dmBots/dm-mc01/README.md

# DM-MC01

[中文](./README.zh.md) | EN

## Overview

This repository contains public materials for the DM-MC01 control board. Only directories with real content are kept, and empty placeholder directories are removed.

## Contents

- [说明书/](说明书/) - Manuals, datasheets, and interface documents
- [2D图纸/](2D图纸/) - 2D drawings, pinout diagrams, schematics, and footprint references
- [3D模型/](3D模型/) - STEP, STP, SolidWorks, and packaged 3D model files
- [例程/](例程/) - Example projects and reference code for the control board

## Maintenance Rules

- Add new materials to the matching Chinese directory and do not add empty placeholder folders.
- Keep 2D drawings and 3D models directly under 2D图纸/ and 3D模型/.
- Keep code projects, third-party projects, and existing archives under their original file names to avoid breaking customer paths.
