dmBots/dm-mc01/models/3d/imu-bmi088-module/DM_imu-V1.0.step

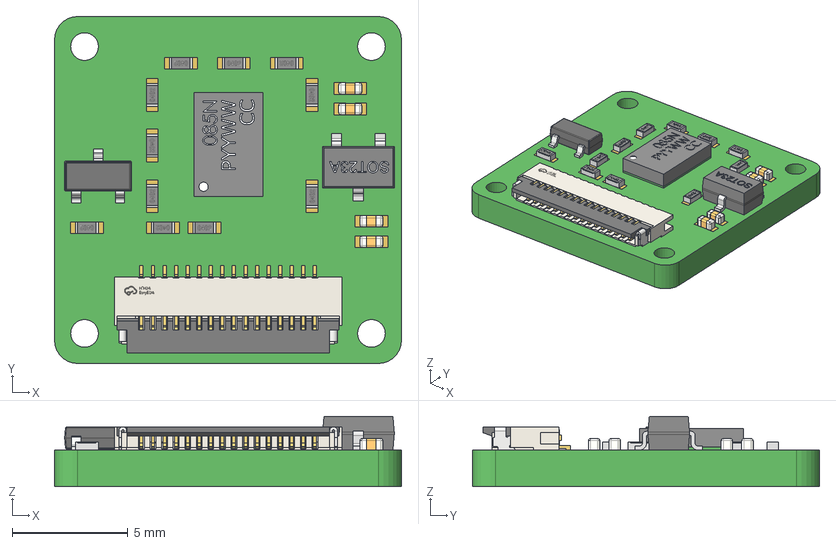
[picture p22: CAD file, 2024-08-02]
models/3d/imu-bmi088-module/DM_imu-V1.0.step
15.0 x 15.0 x 3.03 mm
R0402 x 11
Extruded x 30
User Library-SOT23A
User Library-16-LGA
sot-23-3-infineon
COMPOUND.step
