dmBots/dm-mc01/models/3d/lcd-module/DM_TFT-V1.1.step

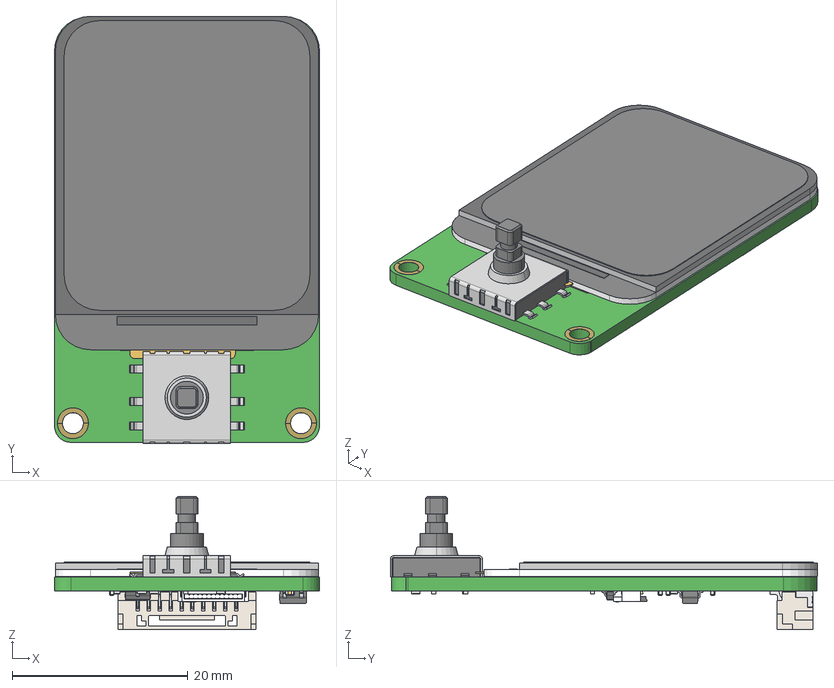
[picture p23: CAD file, 2026-06-29]
models/3d/lcd-module/DM_TFT-V1.1.step
30.2 x 48.7 x 15.2 mm
K1-1504SA-06 x 24
Extruded x 38
User Library-SOT23A
COMPOUND.step
R0402 x 12
sot-23-3-infineon
1.69¡± Round IPS x 57
SOLID.step
