dmBots/dm-mc01/(list of files, cad)

Other CAD files:
V2/models/主控/mc01-v2_0.stp
