dmBots/dm-mc01/说明书/USAGE.md

# DM-MC01 使用说明

## 概述
- 本文档收纳从 README 迁移出来的使用提示和查阅顺序。
- 如果你只想找资料入口，回到 [../README.md](../README.md)。

## 使用流程
1. 先查看本目录内的说明书 PDF。
2. 需要接线或板卡识别时，查看 [图纸/2d/schematics/](../图纸/2d/schematics/) 和 [MC_Board管脚配置图.png](../图纸/2d/MC_Board管脚配置图.png)。
3. 需要模块资料时，按需打开 [图纸/2d/lcd-module/](../图纸/2d/lcd-module/) 和 [图纸/2d/imu-bmi088-module/](../图纸/2d/imu-bmi088-module/)。
4. 需要上手验证时，先看 [示例/](../示例/)；数据参数和封装细节可参考 [datasheets/](datasheets/) 与 [模型/3d/customer-enclosure/](../模型/3d/customer-enclosure/)。

## 备注
- 本目录没有独立的安装脚本或环境初始化流程。
- 未确认内容保持 `TBD` 或 `Translation pending`。
