dmBots/dm-mc01/V2/examples/C593_all/mc01_rc_all_cmake/docs/imu_heater_test_report_2026-09-08.md

# MC01-RC IMU 加热温控实板测试报告

## 1. 测试结论

测试日期：2026-09-08

基于 BMI088 内部温度数据和 TIM2_CH3/PB10 的 1 kHz PWM，IMU 加热闭环温控功能通过实板测试。温度从 30.50°C 上升并稳定在 45°C 附近，记录到的最高温度为 46.25°C，最大过冲为 1.25°C。温控长期运行测试的最终观测温度为 45.000°C，占空比为 15.6%，已连续约 107 秒保持在目标温度 ±0.5°C 范围内，控制器和传感器故障码均为 0。

六轴采集门控也通过实板测试：升温阶段仅以 1 kHz 读取温度；温度连续 10 秒处于 45°C ±0.5°C 后，自动启用加速度计和陀螺仪 1 kHz 采集。门控前六轴样本数保持为 0，门控后读取错误和漏采均为 0。

## 2. 测试环境

- 目标器件：STM32C5A3RGT6
- 温度反馈：BMI088 内部温度数据
- PWM 输出：TIM2_CH3 / PB10
- PWM 配置：1 kHz、PWM1、高有效、初始占空比 0%
- 加热电源使能：PC15，高有效
- 板卡供电：24 V 已接入
- 调试器：DAPLink，UID `D641959C00B43ECC`
- 下载与调试工具：项目 `.venv` 中的 pyOCD
- 构建预设：`debug_GCC_STM32C5A3RGT6`

pyOCD 下载时提示目标包缺少 Flash programming debug sequence，随后自动回退到 FLM；擦除和编程均成功，不影响测试结论。

## 3. 温控参数

| 参数 | 配置 |
| --- | ---: |
| 目标温度 | 45.000°C |
| 过温关闭阈值 | 60.000°C |
| 控制周期 | 20 ms / 50 Hz |
| 稳态判定范围 | 目标温度 ±0.500°C |
| 稳态判定时间 | 连续 10 s |
| 最大占空比 | 50.0% |
| 比例系数 | 20‰/(°C) |
| 积分系数 | 1‰/(°C·s) |
| 温度数据超时 | 500 ms |

参数集中定义在 `board/board_config.h`，用户可以直接修改目标温度、PI 参数、限幅和保护阈值。

## 4. 软件结构

- `board/bsp/bsp_heater.c`：仅封装 TIM2_CH3 启动、千分比占空比设置和安全关闭。
- `app/imu_heater.c`：实现整数 PI、积分抗饱和、温度稳定判定、传感器超时和过温保护。
- `app/imu_test.c`：升温阶段以 1 kHz 读取 BMI088 温度，稳定满 10 秒后再启用加速度计和陀螺仪 1 kHz 采集。
- `main.c`：在现有协作式主循环中依次轮询 IMU 采样和温控应用，不使用阻塞延时。

温控初始化时先关闭加热 5 V，确保 PWM 以 0% 启动后再打开电源。传感器失效、PWM 设置失败或温度达到 60°C 时，会将 PWM 置零、停止 TIM2 通道并关闭加热 5 V 使能。

## 5. 测试方法

1. 使用 CMake Debug 预设编译固件。
2. 使用 DAPLink + pyOCD 下载 ELF 并复位运行。
3. 分阶段暂停 MCU，读取 `imu_heater_status`、`imu_test_status`、TIM2 寄存器和 GPIOC 输出寄存器。
4. 核对升温过程中的温度、误差、占空比、稳态时间、峰值温度和故障状态。
5. 在达到目标后继续运行约 3.5 分钟，检查积分回退和长期稳态。
6. 重新下载采集门控固件，分别在升温阶段、接近目标温度以及稳定满 10 秒后读取温度与六轴计数器。

## 6. 升温与收敛结果

| 控制运行时间 | 温度 | 误差 | 占空比 | 状态 | 已记录峰值 |
| ---: | ---: | ---: | ---: | --- | ---: |
| 约 4.9 s | 33.250°C | +11.750°C | 30.1% | 升温 | 33.250°C |
| 约 37.9 s | 44.750°C | +0.250°C | 23.0% | 调节 | 44.750°C |
| 约 56.0 s | 45.750°C | -0.750°C | 20.2% | 继续调节 | 45.875°C |
| 约 102.3 s | 45.500°C | -0.500°C | 16.2% | 调节 | 46.250°C |
| 约 146.2 s | 45.125°C | -0.125°C | 15.5% | 稳态 | 46.250°C |
| 约 209.0 s | 45.000°C | 0.000°C | 15.6% | 稳态 | 46.250°C |

初始温度和测试期间最低温度均为 30.50°C。最终状态如下：

- `result = 2`：通过
- `state = 3`：稳态
- `fault = 0`：无故障
- 连续稳态时间：约 107.26 s
- 最大过冲：1.25°C

## 7. 稳温后采集门控验证

| 观测点 | 温度 | 温度轮询数 | 六轴样本数 | 六轴采集使能 | 结论 |
| --- | ---: | ---: | ---: | ---: | --- |
| 复位后约 5 s | 39.500°C | 4862 | 0 | 0 | 仅采温度用于温控 |
| 运行约 52.4 s | 44.250°C | 52414 | 0 | 0 | 尚未满足稳态条件，不采集六轴 |
| 连续稳态 30.74 s | 45.250°C | 83370 | 20750 | 1 | 稳定满 10 秒后已自动开始采集 |
| 连续稳态 55.54 s | 45.125°C | 108160 | 45540 | 1 | 六轴继续以 1 kHz 采集 |

最终观测中，连续稳态时间 55540 ms 与六轴样本数 45540 的差值正好为 10000 ms，符合“稳定满 10 秒后开始采集”的配置。门控打开后，温度轮询数和六轴样本数同步按 1 kHz 增长；SPI/API 读取错误为 0，轮询漏采为 0，轮询间隔最小值和最大值均为 1 ms。

## 8. PWM 与 IMU 运行观测

最终 TIM2 寄存器读回：

- `PSC = 143`
- `ARR = 999`
- `CCR3 = 156`
- `CCER.CC3E = 1`
- `CR1.CEN = 1`

以上对应 1 kHz PWM 和 15.6% 占空比。GPIOC 输出寄存器中 PC15 为高电平，加热 5 V 电源保持使能。

采集门控测试的最终 BMI088 状态：

- IMU 测试结果：通过
- 累计温度样本数：108160
- 门控后六轴样本数：45540
- SPI/API 读取错误：0
- 1 kHz 轮询漏采：0
- 轮询间隔最小值/最大值：1 ms / 1 ms

## 9. 结论边界

本次实测证明 1 kHz PWM 输出、BMI088 温度反馈、PI 调节、占空比限幅、稳态控制和稳温后六轴采集门控有效。由于缺少加热小板原理图，当前 50% 最大占空比作为保守限制保留；若更换加热小板、电阻阻值、MOSFET 或机械安装方式，需要重新验证升温速度并调整 PI 参数。

过温和传感器超时关闭路径已进行源码与构建检查。本次没有人为将板卡加热到 60°C 来触发过温保护，以避免不必要的硬件热应力。
