dmBots/dm-mc01/V2/examples/C593_all/mc01_rc_all_cmake/docs/lcd_st7789_test_report_2026-09-08.md

# CtrBoard-V2 ST7789 与五向按键 ADC2 测试报告

- 测试日期：2026-09-08
- 目标 MCU：STM32C5A3RGT6
- 调试下载：DAPLink + pyOCD
- 参考工程：`C:\Users\93094\Desktop\dm-mc02-master\例程\CtrBoard-H7_LCD`
- 测试固件：`build/debug_GCC_STM32C5A3RGT6/mc01_rc_all.elf`

## 1. 结论

旧工程默认 LCD 界面、ST7789 SPI1 TX DMA 驱动和 `ADC2_CH4_KEY` 五向按键原始值采集已完成移植。固件编译、DAPLink 下载和板端运行均通过。

- LCD 初始界面自检：`PASSED`
- ADC2 连续 DMA 采集测试：`PASSED`
- LCD/ADC2 DMA 错误：0
- ADC2 采样超时：0
- 既有 CAN、RS485、USART、VBAT、BMI088、IMU 加热和 TIM8 测试：均为 `PASSED`

LCD 为只写接口，板端无法回读显存，因此文字和图片最终外观仍需人工观察确认；MCU 侧命令、数据长度、DMA 完成和刷新计数均已验证。

## 2. 旧例程默认界面核对

旧工程 `Core/Src/main.c` 的默认流程不是单独显示一张图片，而是：

1. 初始化 LCD 并清为黑色。
2. 在 `(120,72)` 显示棕红色 `dmBot`，12×24 ASCII 字体。
3. 在 `(84,100)` 显示白色 `达妙科技`，32×32 汉字字模。
4. 在 X=10 和 X=270 位置绘制两条白色竖线。
5. 在 `(50,170)` 以 16×32 ASCII 字体显示 5 位 ADC 按键原始值。
6. 在 `(180,150)` 显示右下角图片。

当前例程已按上述布局恢复。旧代码把高度 240 的屏幕竖线画到 Y=280，本次将终点限制为 Y=239，避免越界。

## 3. LCD 硬件配置

| 屏幕信号 | 原理图网络/MCU 引脚 | 配置 | 作用 |
| --- | --- | --- | --- |
| CS | SPI1_CS / PA4 | GPIO 推挽输出，初始高 | 软件片选，低有效 |
| SCK | SPI1_SCK / PA5 | SPI1 AF5 | 串行时钟 |
| SDA | SPI1_MOSI / PA7 | SPI1 AF5 | 单向显示数据 |
| BLK | IIC2_SCL / PB3 | GPIO 推挽输出 | 背光，高有效 |
| RES | IIC2_SDA / PB4 | GPIO 推挽输出、上拉 | 硬件复位，低有效 |
| DC | PC01 / PC1 | GPIO 推挽输出 | 命令/数据选择 |

`IIC2_SCL` 和 `IIC2_SDA` 在 LCD 用途中只是原理图网络名，分别作为 BLK 和 RES 普通 GPIO 输出，不启用 I2C 功能。

SPI1 配置为主机、8 bit、MSB first、CPOL Low、CPHA 1 Edge（Mode 0）、内部 NSS、预分频 16。板端实测 SPI1 内核时钟 144 MHz，SCLK 为 9 MHz。SPI1 TX 使用 LPDMA2 Channel 3。

## 4. ADC2 五向按键配置

| 项目 | 配置 |
| --- | --- |
| 网络名 | ADC2_CH4_KEY |
| MCU 引脚 | PC4 / ADC2_IN4 |
| 分辨率 | 12 bit |
| 采样时间 | 289 cycles |
| 转换方式 | 软件触发、单次规则组转换 |
| DMA | LPDMA2 Channel 2，外设到内存，word 宽度 |
| 采样周期 | 20 ms |
| LCD 刷新周期 | 100 ms |
| 单次采样超时 | 10 ms |

旧例程只显示 ADC 原始值，没有给出上、下、左、右、中心五个档位的电压阈值。本次保持这一行为，不对阈值作未经实测的假设；BSP 和应用 API 已提供 12 位原始值及序号，后续可采集五个按键档位后增加方向解析。

## 5. 软件结构

- `board/board_config.h`：LCD 与按键 ADC 的周期、超时、尺寸及引脚配置。
- `board/bsp/bsp_lcd.c/.h`：轻量 LCD 总线接口，负责 GPIO、SPI1 DMA 和中断事件。
- `board/bsp/bsp_adc.c/.h`：ADC1 VBAT 与 ADC2 KEY 共用的轻量异步 DMA 采样实现。
- `app/key_test.c/.h`：按键连续采样、状态统计及最新原始值用户接口。
- `app/lcd.c/.h`：ST7789 非阻塞初始化、区域填充和 RGB565 图片发送。
- `app/lcd_font.c/.h`：只迁移默认界面使用的 ASCII 24、ASCII 32 和四个中文 32 字模。
- `app/lcd_picture.c/.h`：旧工程 RGB565 图片资源。
- `app/lcd_test.c/.h`：旧默认界面绘制、初始计数自检和按键值持续刷新状态机。

ADC 与 SPI 中断回调只设置完成/错误标志。停止 DMA、发布采样、界面步骤推进和刷新均在主循环轮询中处理。

## 6. 资源核对与修正

| 资源 | 大小 |
| --- | ---: |
| ASCII 12×24 字库 | 4560 字节 |
| ASCII 16×32 字库 | 6080 字节 |
| `达妙科技` 四个 32×32 字模 | 512 字节 |
| 旧 RGB565 图片 | 12160 字节 |

图片数组长度和元数据对应 80×76。旧工程调用 `LCD_ShowPicture(180,150,80,80,...)` 会越界读取 640 字节；本次按真实尺寸 80×76 显示，并保持 RGB565 高字节在前。

## 7. LCD 初始界面精确自检

初始界面包括清屏、`dmBot`、四个汉字、两条竖线、图片和第一次 ADC 数值，共 7 次绘制操作。

| 检查项 | 期望值 | 初始实测/判定 |
| --- | ---: | --- |
| 初始化命令数 | 15 | 15，通过 |
| DMA 完成次数 | 383 | 383，通过 |
| SPI 发送字节数 | 163847 | 163847，通过 |
| 绘制操作数 | 7 | 7，通过 |
| 发送像素数 | 81856 | 81856，通过 |
| 图片完成标志 | 1 | 1，通过 |
| LCD BSP 错误 | 0 | 0，通过 |
| LCD 驱动错误 | 0 | 0，通过 |

完成精确计数核对后，LCD 测试结果置为 `PASSED`，随后进入五向按键原始值持续刷新状态。

## 8. 持续运行实测快照

在固件持续运行约 42.8 秒后通过 SWD 读取：

### ADC2 KEY

| 字段 | 实测值 |
| --- | ---: |
| 测试结果 | PASSED (`2`) |
| 采样次数 | 2141 |
| 最新原始值 | 4007 |
| 最新引脚电压 | 3229 mV |
| DMA 完成次数 | 2141 |
| ADC 错误 | 0 |
| 超时次数 | 0 |

### LCD 持续刷新

| 字段 | 实测值 |
| --- | ---: |
| 测试结果 | PASSED (`2`) |
| 状态 | ACTIVE (`16`) |
| 失败掩码 | 0 |
| 屏幕上的按键原始值 | 4012 |
| 按键数值绘制次数 | 399 |
| 图片完成标志 | 1 |
| DMA 完成次数 | 6353 |
| SPI 发送字节数 | 2205985 |
| 绘制操作数 | 405 |
| 发送像素数 | 1100736 |
| LCD BSP/驱动错误 | 0 / 0 |

屏幕值与 ADC 最新值存在几毫秒级刷新时差属于正常现象。持续计数符合以下关系：

- DMA 次数 = `368 + 按键数值绘制次数 × 15`
- 发送字节 = `158716 + 按键数值绘制次数 × 5131`
- 绘制操作 = `6 + 按键数值绘制次数`
- 发送像素 = `79296 + 按键数值绘制次数 × 2560`

实测 399 次刷新全部满足上述关系，说明持续 DMA 分块和轮询调度没有丢失操作。

## 9. 既有功能回归

| 模块 | 最终固件状态 |
| --- | --- |
| CAN（当前 CANFD 8 Mbit/s 预设） | PASSED，mask `0x0F` |
| RS485 2 Mbaud 外部 Echo | PASSED，mask `0x3F` |
| USART1/USART3 单口回环 | PASSED，mask `0x3F` |
| VBAT ADC1 DMA | PASSED，100 个样本 |
| BMI088 | PASSED |
| IMU 加热控制 | PASSED，无故障 |
| TIM8 PWM 捕获回环 | PASSED |

## 10. 人工观察项

屏幕应为黑底，显示 `dmBot`、`达妙科技`、左右白线、右下角图片，以及位于 `(50,170)` 的五位 ADC 原始值。按动五向键时，该数值应随分压档位变化。若需要显示方向名称，应先记录松开、上、下、左、右、中心六种状态的稳定原始值，再配置判定区间。
