dmBots/dm-mc01/V2/drawings/管脚标注图.pdf

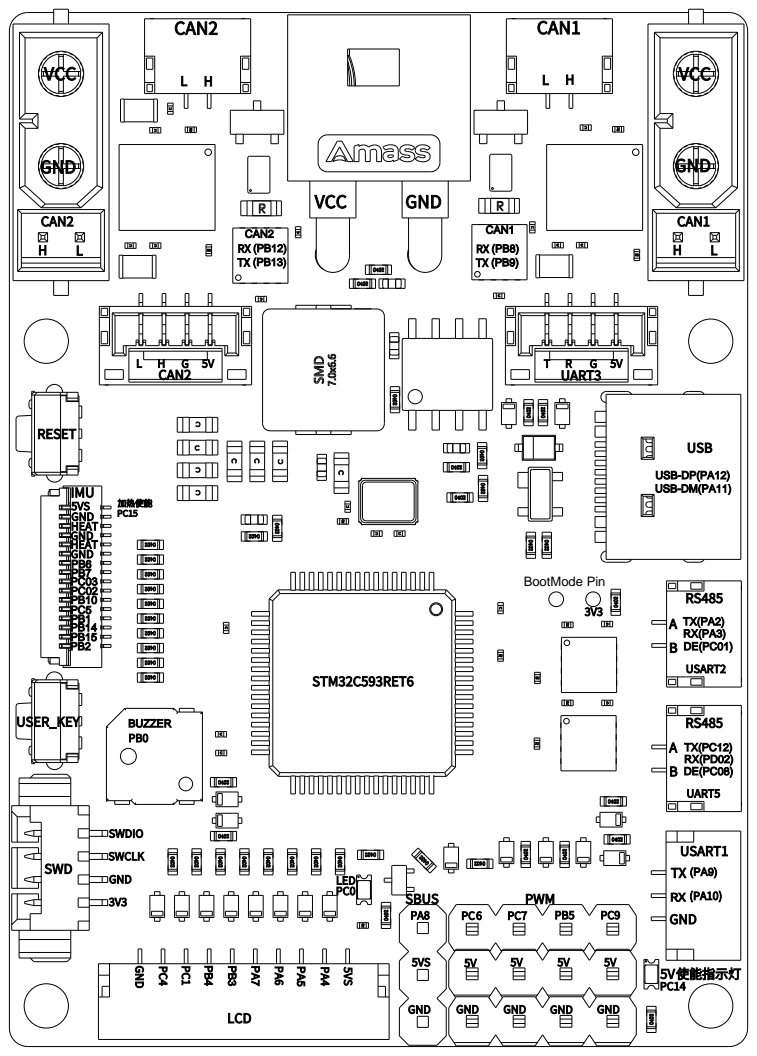
[picture p24: page 1]
BootMode Pin
