dmBots/dm-mc01/V2/drawings/DM_TFT-V1.1.pdf

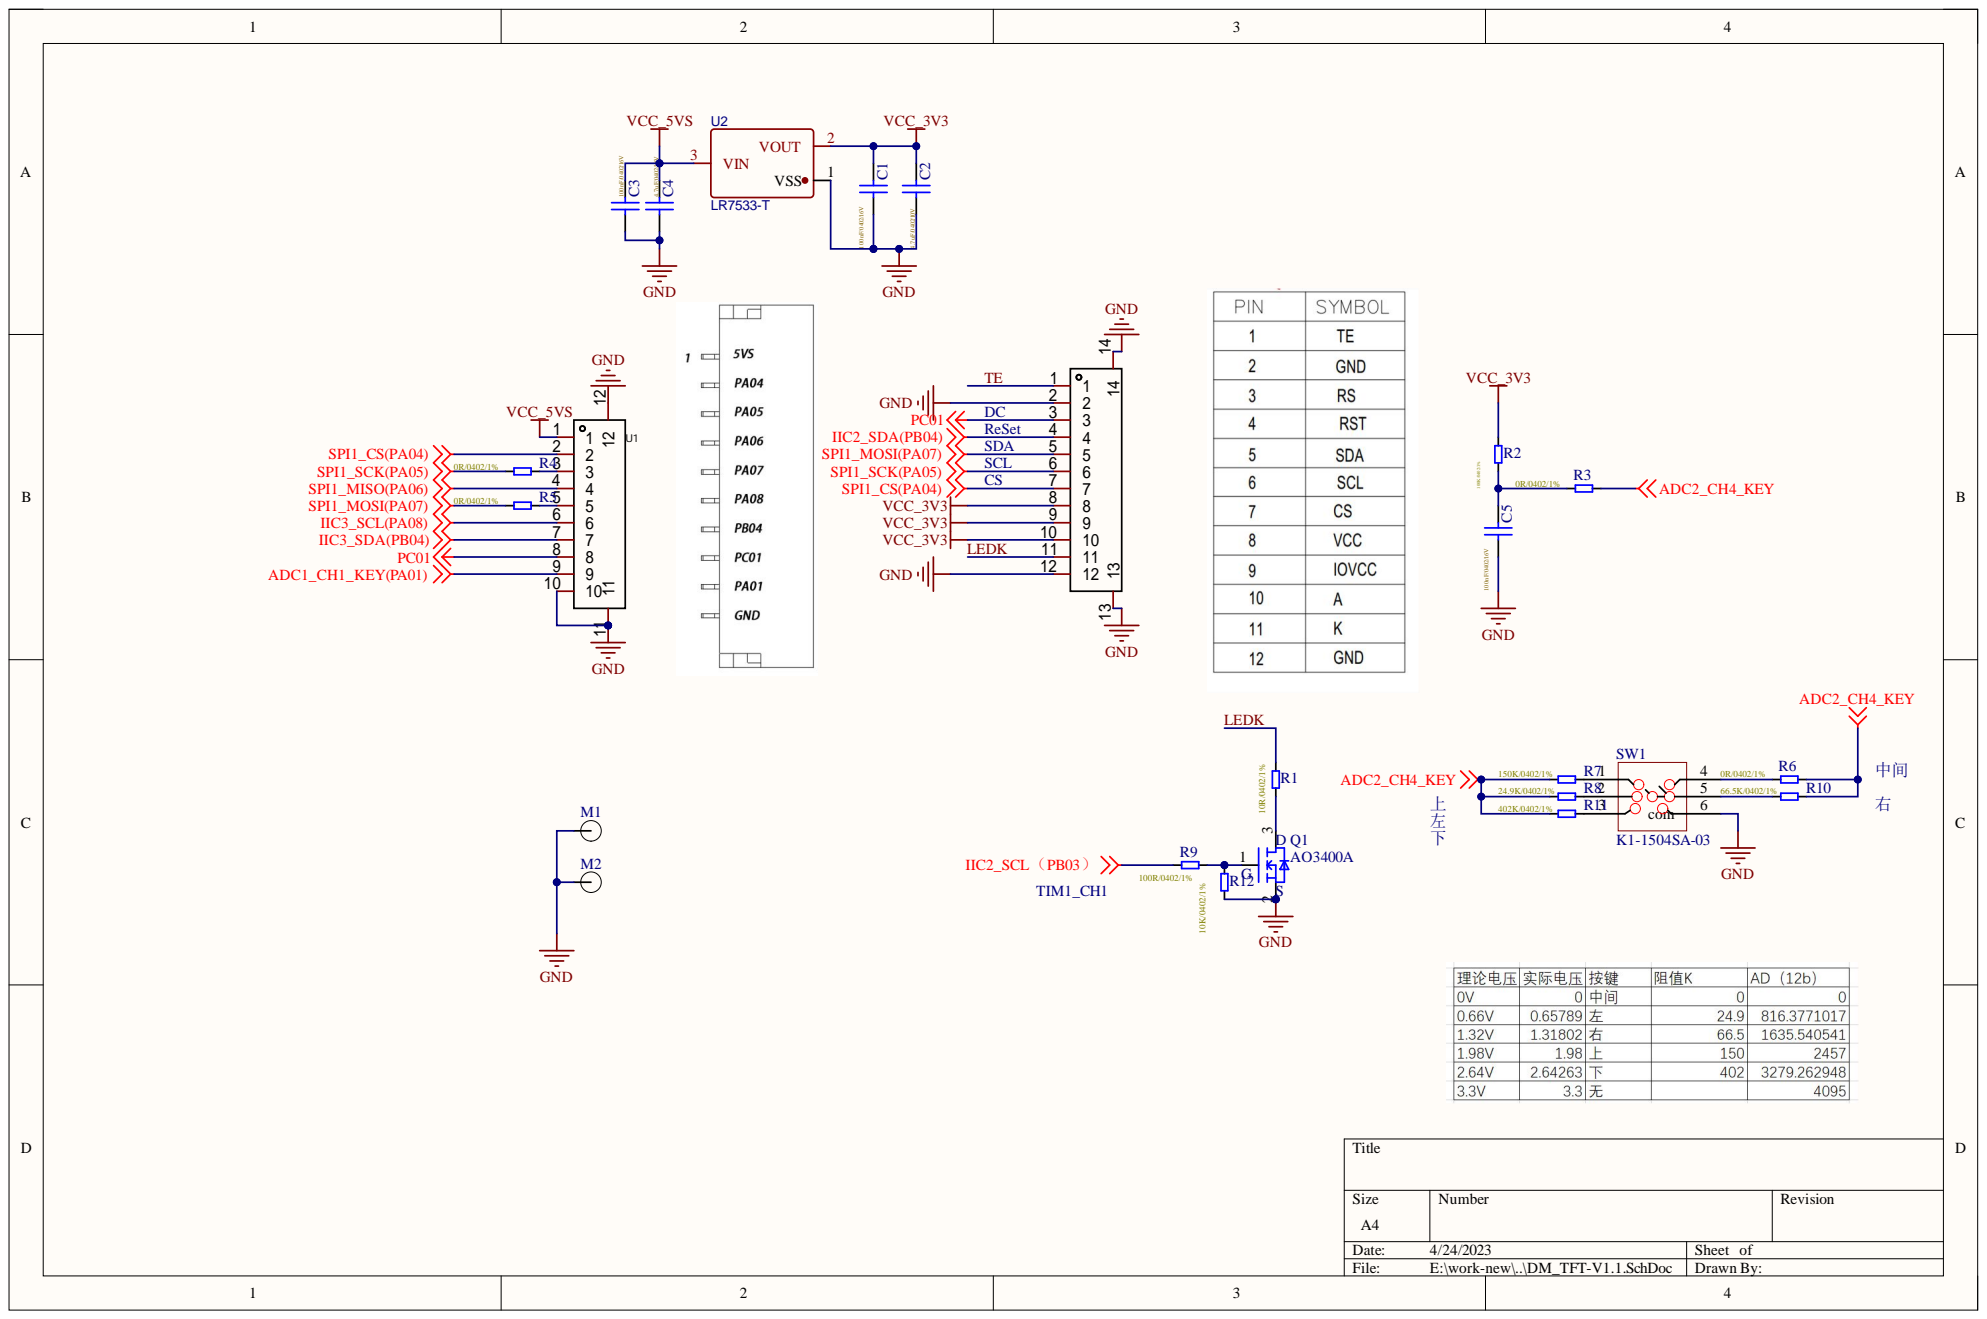
[picture p25: page 1]
