dmBots/dm-mc01/V2/drawings/mc01-v2_0.pdf

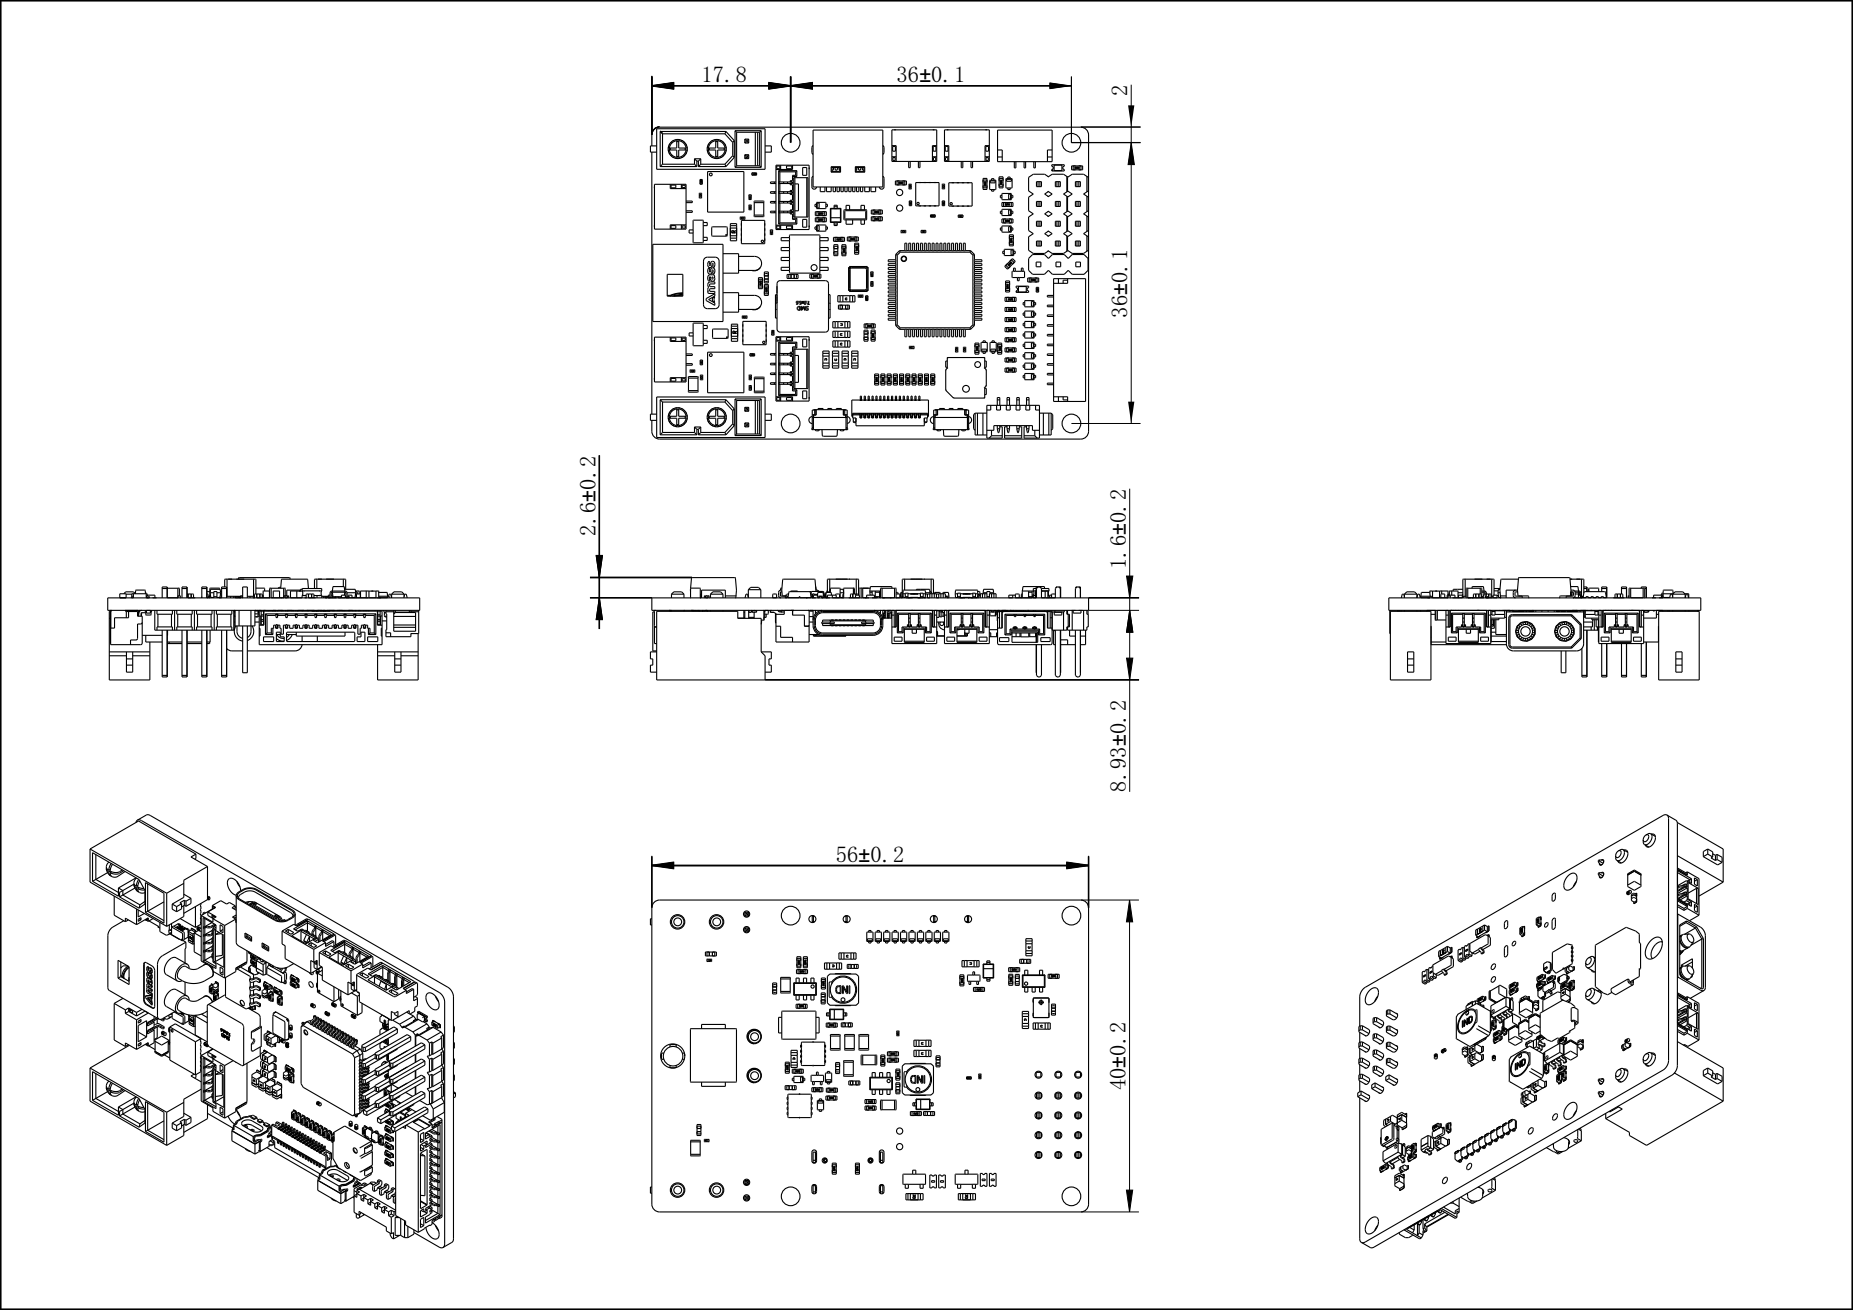
[picture p26: page 1]
