dmBots/dm-mc01/V2/drawings/MC_Board原理图.pdf

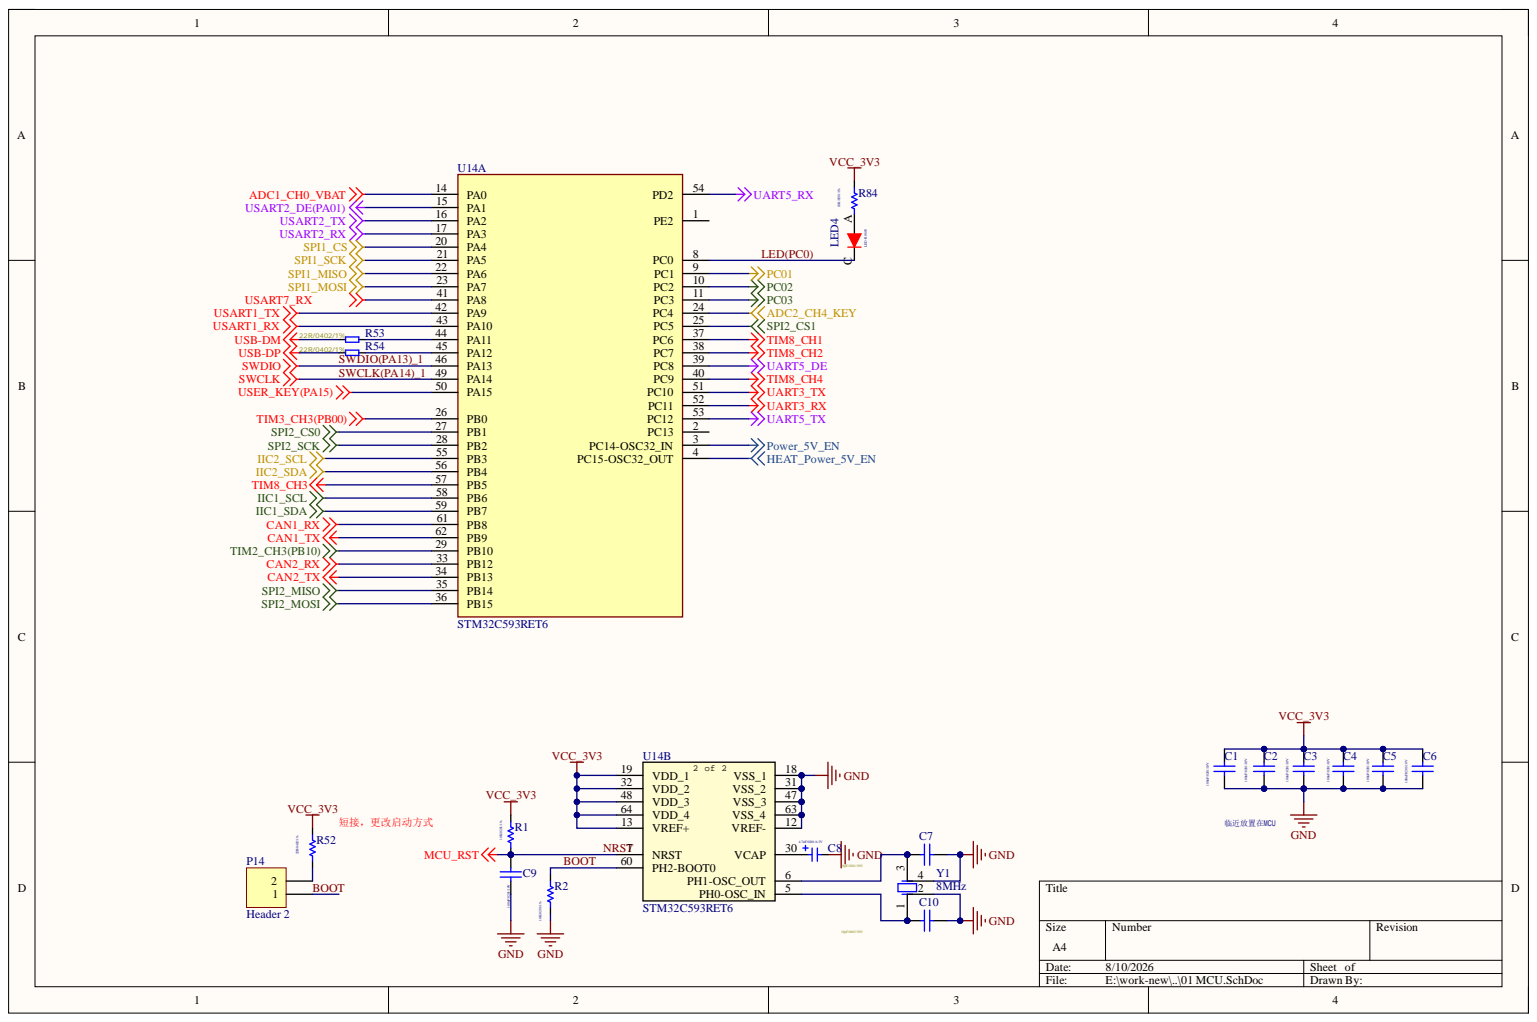
[picture p27: page 1]

4 | Y1
2 8MHz

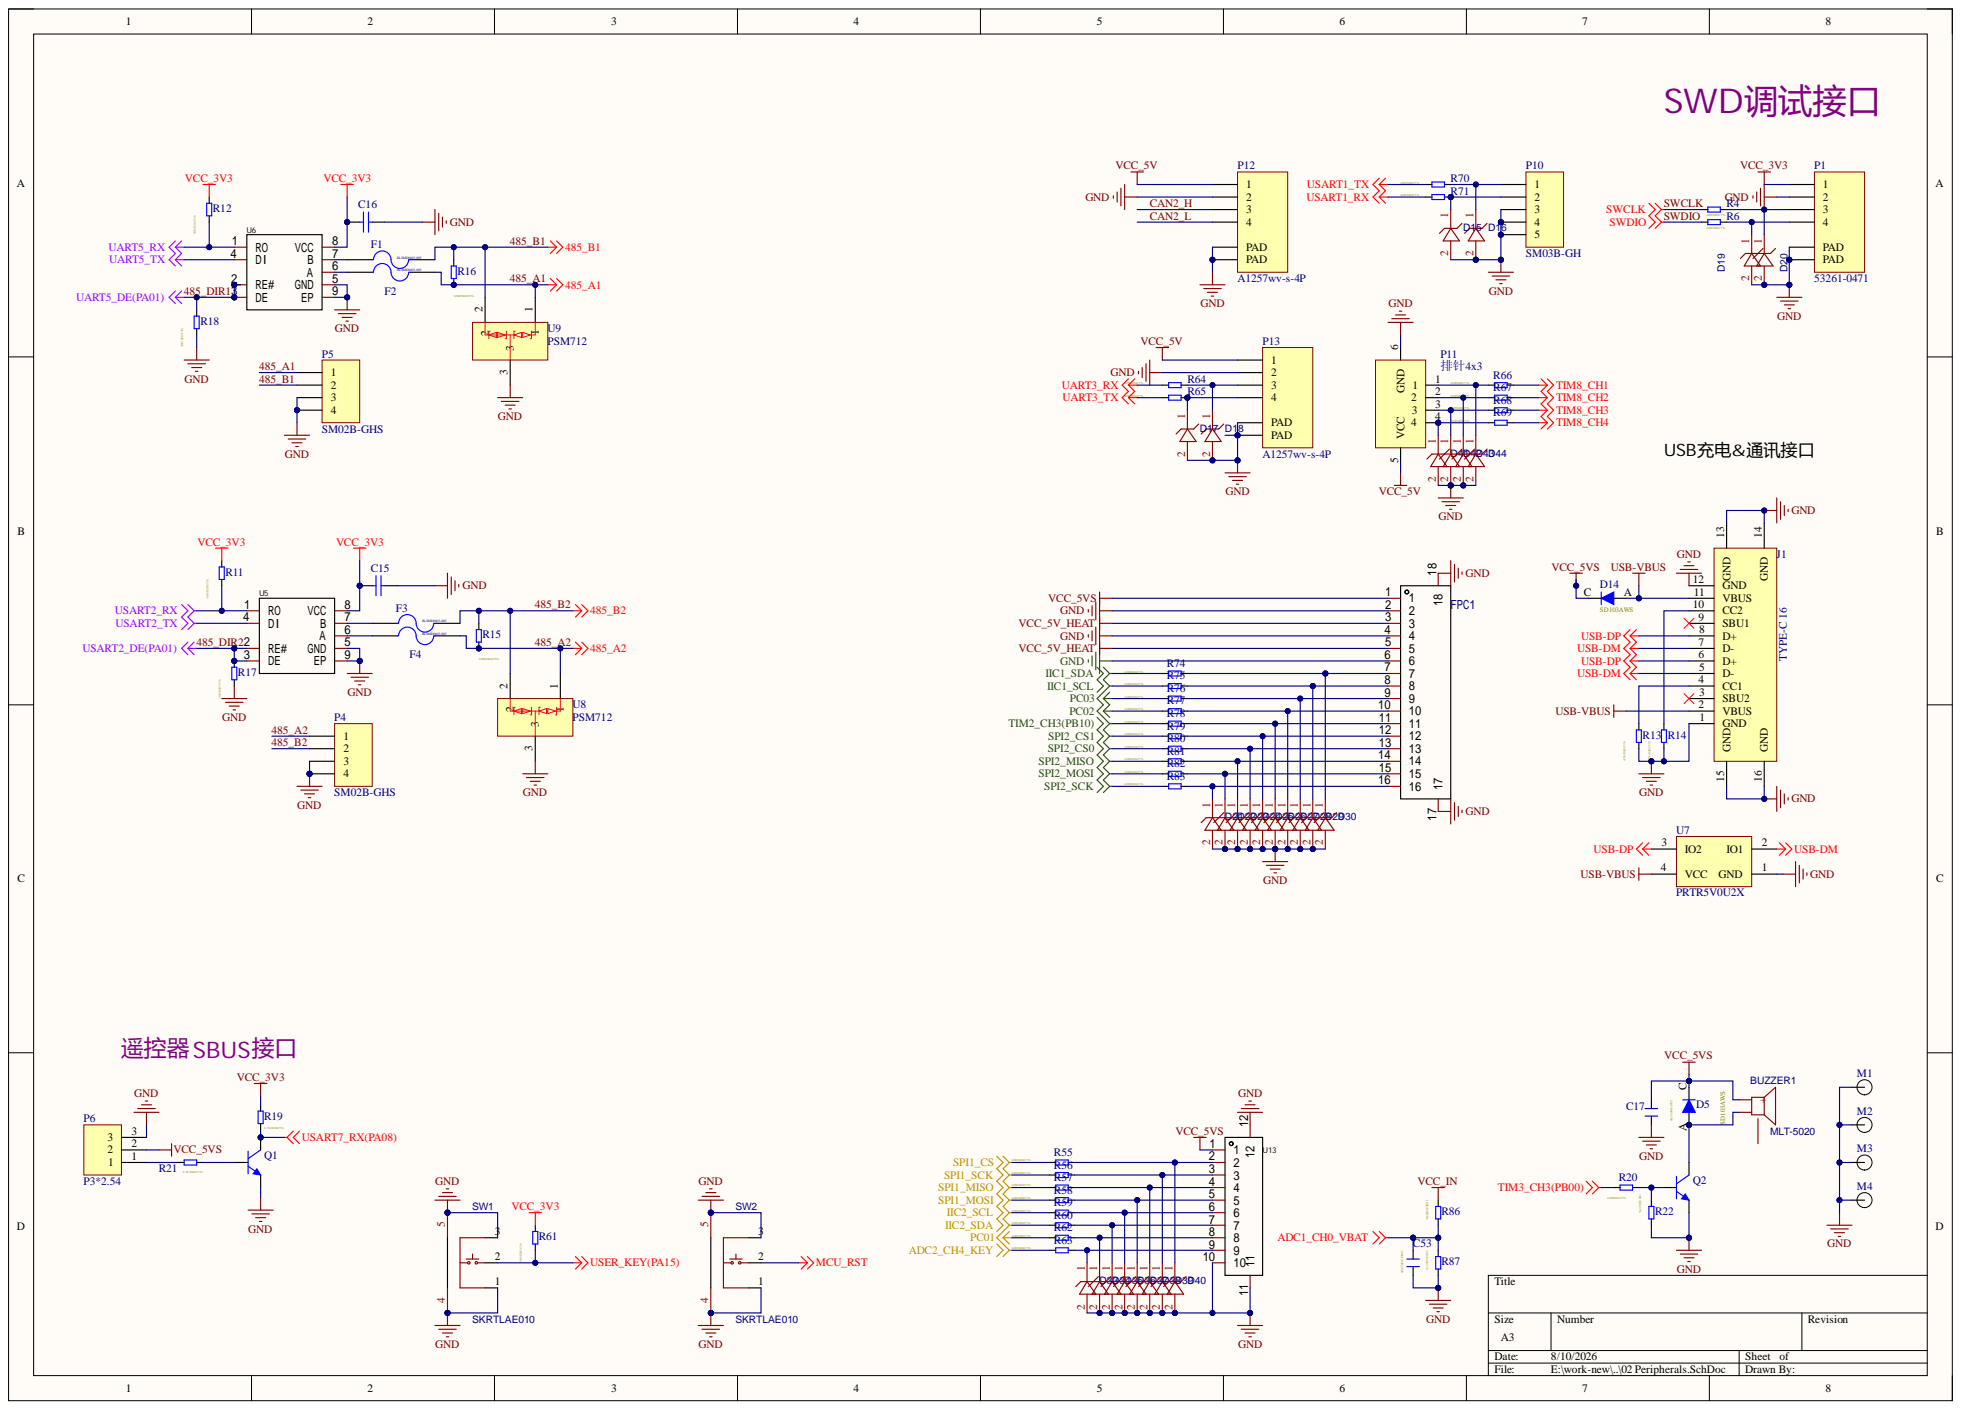
[picture p28: page 2]

10 10
11 11

13 13
14 14
15 15
16 16

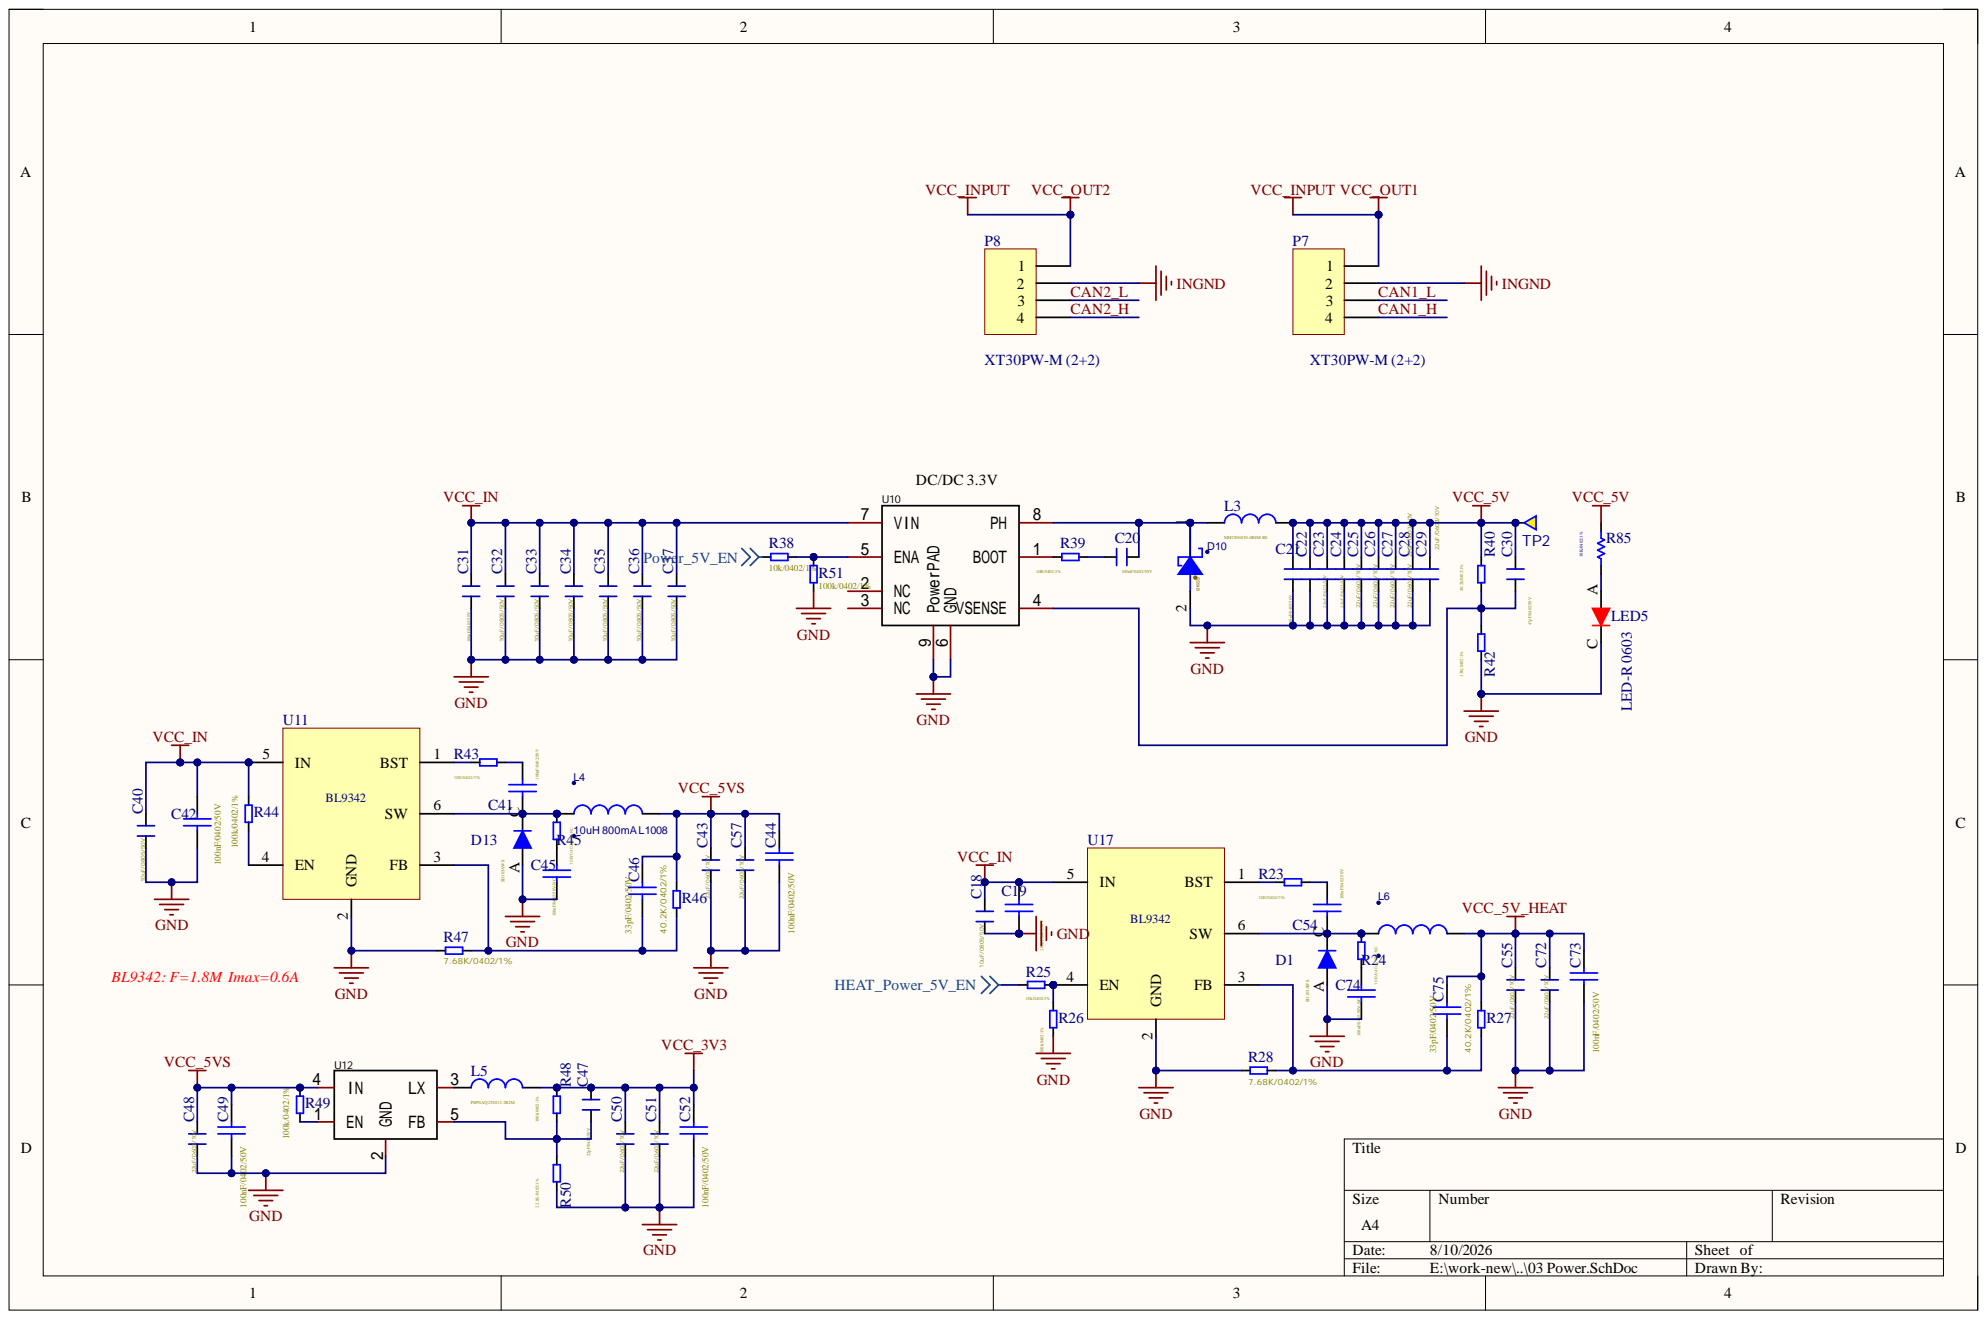
[picture p29: page 3]

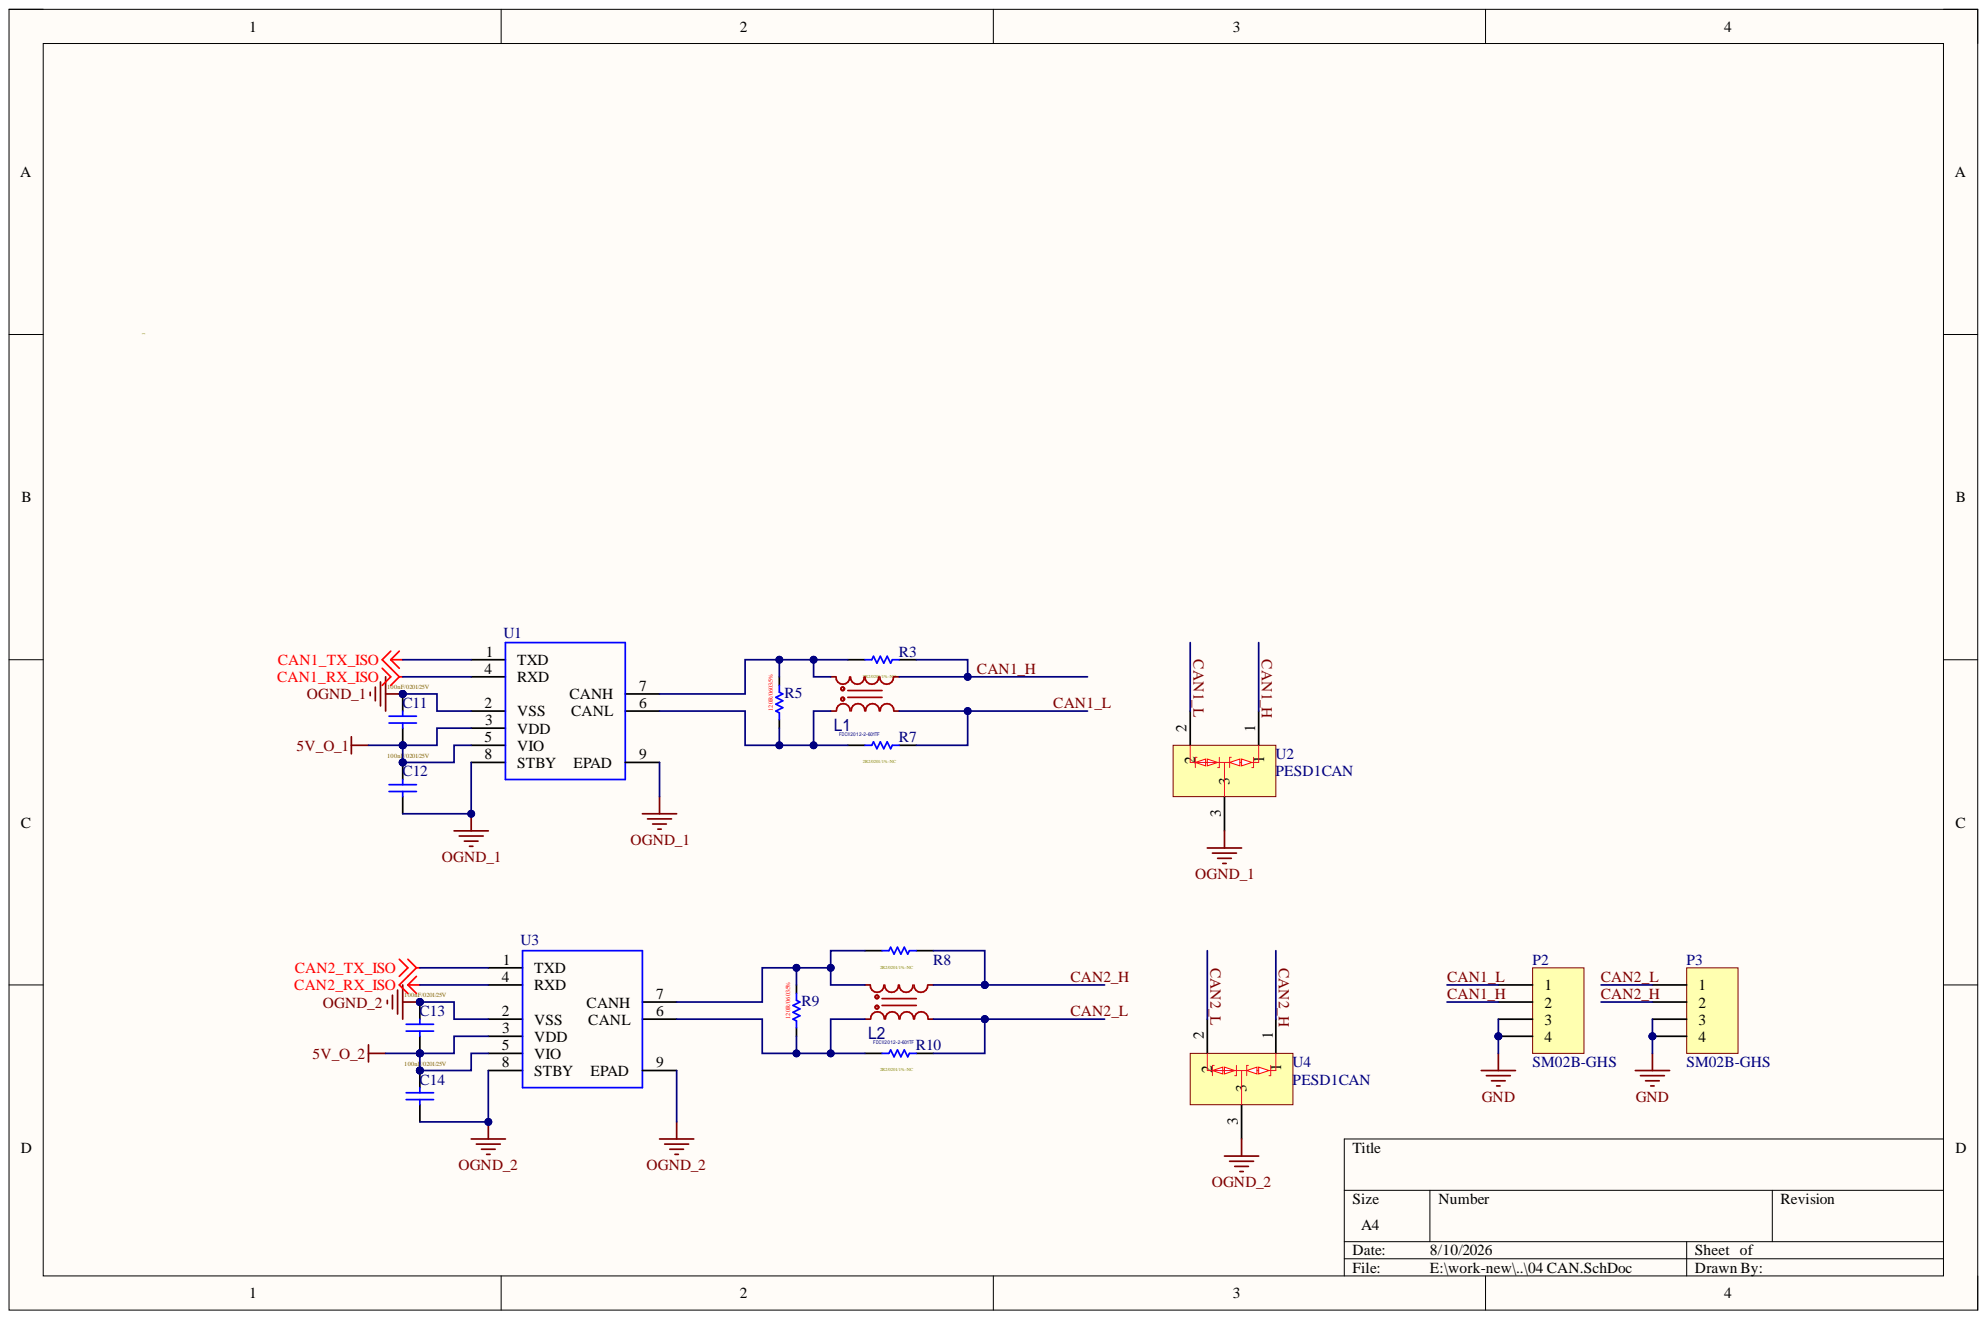
[picture p30: page 4]

VIO 5
STBY 8

VDD 3
