dmBots/dm-mc01/V2/examples/C593_all/mc01_rc_all_cmake/app/lcd_font.c

#include "lcd_font.h"

#include <stddef.h>

static const uint8_t lcd_ascii24[][48] = {
{0x00,0x00,0x00,0x00,0x00,0x00,0x00,0x00,0x00,0x00,0x00,0x00,0x00,0x00,0x00,0x00,0x00,0x00,0x00,0x00,0x00,0x00,0x00,0x00,0x00,0x00,0x00,0x00,0x00,0x00,0x00,0x00,0x00,0x00,0x00,0x00,0x00,0x00,0x00,0x00,0x00,0x00,0x00,0x00,0x00,0x00,0x00,0x00},/*" ",0*/
{0x00,0x00,0x00,0x00,0x00,0x00,0x00,0x00,0x60,0x00,0x60,0x00,0x60,0x00,0x60,0x00,0x60,0x00,0x60,0x00,0x60,0x00,0x40,0x00,0x20,0x00,0x20,0x00,0x20,0x00,0x00,0x00,0x00,0x00,0x00,0x00,0x60,0x00,0x60,0x00,0x60,0x00,0x00,0x00,0x00,0x00,0x00,0x00},/*"!",1*/
{0x00,0x00,0x00,0x00,0x60,0x06,0x60,0x06,0x30,0x03,0x98,0x01,0x88,0x00,0x44,0x00,0x00,0x00,0x00,0x00,0x00,0x00,0x00,0x00,0x00,0x00,0x00,0x00,0x00,0x00,0x00,0x00,0x00,0x00,0x00,0x00,0x00,0x00,0x00,0x00,0x00,0x00,0x00,0x00,0x00,0x00,0x00,0x00},/*""",2*/
{0x00,0x00,0x00,0x00,0x00,0x00,0x00,0x00,0x10,0x02,0x10,0x02,0x10,0x02,0x10,0x02,0xFE,0x07,0xFE,0x07,0x08,0x02,0x08,0x01,0x08,0x01,0x08,0x01,0x08,0x01,0xFE,0x07,0xFE,0x07,0x04,0x01,0x04,0x01,0x04,0x01,0x04,0x01,0x00,0x00,0x00,0x00,0x00,0x00},/*"#",3*/
{0x00,0x00,0x00,0x00,0x00,0x00,0x40,0x00,0x40,0x00,0xF0,0x01,0x58,0x03,0x4C,0x03,0xCC,0x03,0x4C,0x00,0x58,0x00,0x70,0x00,0xE0,0x00,0xC0,0x01,0xC0,0x01,0x40,0x03,0x4C,0x03,0x5C,0x03,0x4C,0x03,0x48,0x01,0xF0,0x00,0x40,0x00,0x40,0x00,0x00,0x00},/*"$",4*/
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
        0x80,0x01,0x86,0x01,0x80,0x01,0x84,0x01,0x80,0x01,0xCC,0x00,0x80,0x01,0x68,0x00,
        0x80,0x01,0x70,0x00,0x80,0x01,0x78,0x00,0x80,0x01,0xEC,0x00,0x80,0x01,0xC7,0x03,
        0xF8,0x81,0x01,0x1F,0xE0,0x71,0x00,0x3E,0x40,0x0C,0x00,0x00,0x00,0x00,0x00,0x00
    }
};

const uint8_t *lcd_font_get_ascii24(uint8_t character)
{
    if ((character < LCD_FONT_ASCII_FIRST) || (character > LCD_FONT_ASCII_LAST))
    {
        return NULL;
    }
    return lcd_ascii24[character - LCD_FONT_ASCII_FIRST];
}

const uint8_t *lcd_font_get_ascii32(uint8_t character)
{
    if ((character < LCD_FONT_ASCII_FIRST) || (character > LCD_FONT_ASCII_LAST))
    {
        return NULL;
    }
    return lcd_ascii32[character - LCD_FONT_ASCII_FIRST];
}

const uint8_t *lcd_font_get_chinese32(uint32_t index)
{
    if (index >= LCD_FONT_CHINESE32_COUNT)
    {
        return NULL;
    }
    return lcd_chinese32[index];
}
