dmBots/dm-mc01/V2/examples/C593_all/mc01_rc_all_cmake/app/lcd_picture.c

#include "lcd_picture.h"

const uint8_t lcd_picture_data[LCD_PICTURE_DATA_SIZE] = {
 /* 0X10,0X10,0X00,0X50,0X00,0X4C,0X01,0X1B, */
0XC5,0XB3,0XC5,0XB3,0XC5,0XB3,0XC5,0XB3,0XC5,0XB4,0XC5,0XB4,0XC5,0XB3,0XC5,0XB3,
0XC5,0XB3,0XC5,0XB3,0XC5,0XB3,0XC5,0X92,0XBD,0X92,0XBD,0X92,0XBD,0X92,0XBD,0X92,
0XBD,0X92,0XBD,0X92,0XBD,0X72,0X83,0XAC,0X73,0X2B,0X73,0X2B,0X62,0XEA,0X62,0XA9,
0X5A,0XA9,0X5A,0X89,0X5A,0XA8,0X5A,0XA8,0X41,0XE5,0X5A,0XA8,0X63,0X09,0X7B,0XCC,
0X8C,0X0E,0X8C,0X4E,0X94,0X6F,0X8C,0X4E,0X8C,0X0E,0X8C,0X2E,0X94,0X4F,0X94,0X6F,
0X9C,0XD0,0XA5,0X12,0XAD,0X32,0XAD,0X52,0XB5,0X73,0XB5,0X93,0XBD,0XB4,0XBD,0XD4,
0XBD,0XD4,0XBD,0XD4,0XC5,0XD5,0XC5,0XD5,0XC5,0XD5,0XC5,0XD5,0XC5,0XD5,0XC5,0XF5,
0XC5,0XF5,0XC5,0XF5,0XC5,0XD5,0XC5,0XD5,0XC5,0XD5,0XC5,0XD5,0XBD,0XB4,0XB5,0X93,
0XB5,0X73,0XAD,0X32,0XAD,0X12,0X94,0X6F,0X7B,0X8C,0X6B,0X2A,0X62,0XC9,0X62,0XC9,
0X62,0XC9,0X62,0XE9,0X62,0XE9,0X62,0XE9,0X62,0XE9,0X62,0XE9,0X62,0XE9,0X62,0XE9,
0XC5,0XB3,0XC5,0XB3,0XC5,0XB3,0XC5,0XB3,0XC5,0XB4,0XC5,0XB4,0XC5,0XB3,0XC5,0XB3,
0XC5,0XB3,0XC5,0XB3,0XC5,0XB3,0XC5,0XB3,0XC5,0X92,0XBD,0X92,0XBD,0X92,0XBD,0X92,
0XC5,0X93,0XBD,0X72,0X73,0X4A,0X73,0X2B,0X6B,0X0B,0X62,0XCA,0X5A,0XA9,0X5A,0XA9,
0X5A,0XA9,0X5A,0XA9,0X5A,0XA8,0X6B,0X4B,0XAD,0X12,0XB5,0X73,0XAD,0X12,0XA4,0XF1,
0X9C,0XB0,0X94,0X6F,0X94,0X6F,0X94,0X8F,0X9C,0XB0,0XA4,0XD1,0XA5,0X11,0XAD,0X32,
0XB5,0X73,0XBD,0X94,0XBD,0XB4,0XBD,0XD4,0XC5,0XD5,0XC5,0XD5,0XC5,0XF5,0XC5,0XF5,
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
0X6B,0X6D,0X6B,0X8D,0X63,0X4C,0X6B,0X6C,0X6B,0X6C,0X6B,0X6D,0X6B,0X8D,0X73,0X8D,
0X39,0XE7,0XBD,0XF7,0XBD,0XD6,0XB5,0XB6,0X52,0X8A,0XAD,0X34,0XC5,0XF7,0XC5,0XF7,
0XC5,0XD7,0XA5,0X14,0X83,0XF0,0X73,0X6E,0X62,0XEC,0X73,0X4D,0X73,0X4D,0X5A,0X8A,
};
