dmBots/dm-mc01/(commit log)

2024-08-19 新增IMU手册
2026-06-29 docs: normalize public material structure
    [DM_TFT-V1.1.step, DM_imu-V1.0.step]
2026-06-30 chore: localize control board materials
    [DM_TFT-V1.1.step, DM_imu-V1.0.step]
2026-06-30 chore: sync public materials from governed source
